smakonin/APMR/resources/apmr_hardware.png

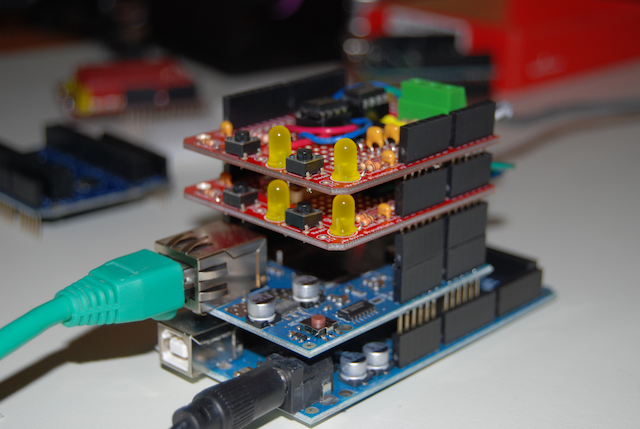
resources/apmr_hardware.png
