smakonin/APMR/resources/rs485_shield.png

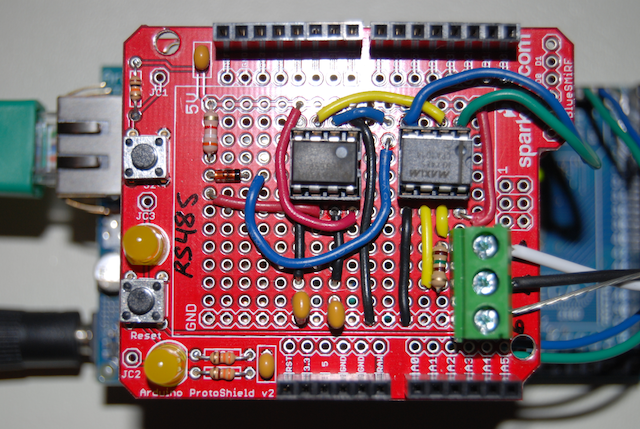
resources/rs485_shield.png
