smakonin/APMR/README.md

# Arduino Power Meter Reader (APMR)

Log real power (W) and energy (Wh) readings from RS485/Modbus communicating meters. Want to learn more? [See the  project page](http://smakonin.github.com/APMR).

This project is here by released under the [COMMON DEVELOPMENT AND DISTRIBUTION LICENSE (CDDL)](https://raw.github.com/smakonin/APMR/master/LICENSE).

Copyright (C) 2010-2012 Stephen Makonin and contributors. All rights reserved.
