smakonin/APMR/IHD/imp_plan.png

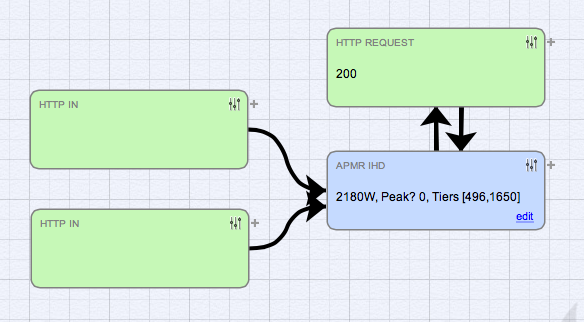
IHD/imp_plan.png
