smakonin/APMR/resources/rtc_shield.png

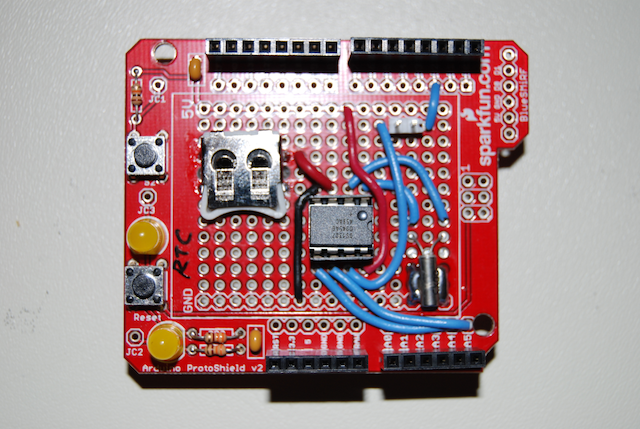
resources/rtc_shield.png
