smakonin/APMR/resources/rtc_shield_schematic.pdf

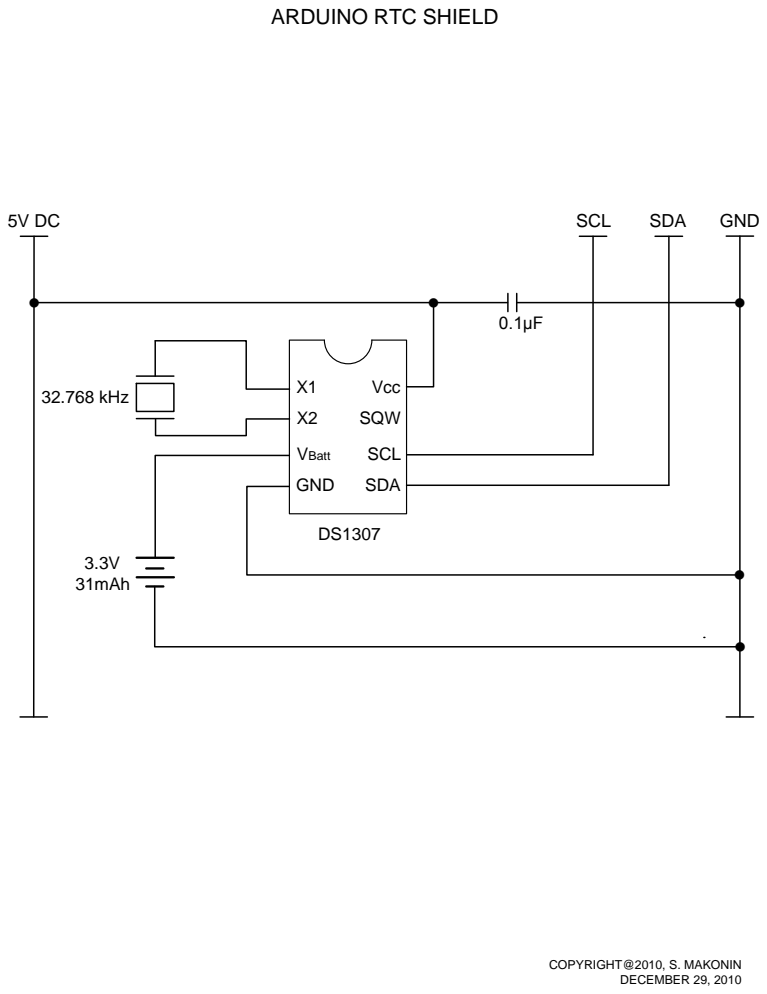
[picture p11: page 1]
COPYRIGHT@2010, S. MAKONIN DECEMBER 29, 2010; 32.768 kHz; GND

ARDUINO RTC SHIELD
