smakonin/APMR/(commit log)

2012-07-05 bug fixes to work with Arduino 1.0.1
    [APMR.ino]
2012-10-10 new schematic files
